Lucas-byte31/GREENHOUSE_V2/02_SW_SPEC/Photos/Menu5_KO_FAN.png

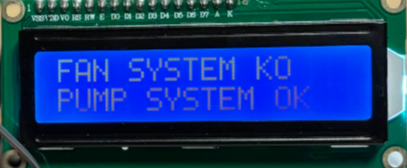
02_SW_SPEC/Photos/Menu5_KO_FAN.png
