Lucas-byte31/GREENHOUSE_V2/02_SW_SPEC/System_spec_v2.docx

# System Requirements SR – GREENHOUSE V2

Révision du document : v2 du 04/11/2026 – Migration STM32 (STM32CubeIDE) vers ESP32 (Arduino IDE) et introduction du temps réel (FreeRTOS).

Statuts : Inchangé = exigence V1 reconduite telle quelle ; Modifié v2 = exigence V1 précisée/quantifiée ; Nouveau v2 = exigence ajoutée ; Proposé v2 (à valider) = évolution de comportement soumise à validation ; Optionnel v2 = exigence souhaitable, non bloquante.

Méthodes de vérification : T = Test, M = Mesure, A = Analyse, I = Inspection (revue de code / de document).

## Template

SR-GH-0xx

Révision xx

Objet :

Rationale :

Vérification : T / M / A / I

Statut :

## Exigences fonctionnelles

SR-GH-001

Révision 01

Objet : Greenhouse doit pouvoir acquérir la température ambiante sur la plage 0 à 50 °C, avec une résolution affichée de 1 °C.

Rationale : Capteur TMP235 (10 mV/°C, 500 mV à 0 °C) : T = 100 × V − 50. Sur ESP32, la tension est lue en mV par analogReadMilliVolts() car l’ADC de l’ESP32 n’est pas linéaire (la conversion brute × 3,3 / 4095 de la V1 n’est plus valable).

Vérification : T – comparaison avec un thermomètre de référence (écart ≤ 2 °C).

Statut : Modifié v2

SR-GH-002

Révision 01

Objet : Greenhouse doit pouvoir acquérir l’humidité du sol sur la plage 0 à 100 %.

Rationale : Capteur capacitif Grove 101020614 : la tension de sortie diminue quand l’humidité augmente. H = (V_air − V) / (V_air − V_eau) × 100, saturée entre 0 et 100 %. Les points d’étalonnage V_air (air sec) et V_eau (immergé) sont à remesurer en mV sur la cible ESP32 (les valeurs V1 étaient en points ADC STM32).

Vérification : T – étalonnage air / eau puis contrôle à mi-plage.

Statut : Modifié v2

SR-GH-003

Révision 00

Objet : Greenhouse doit pouvoir être interactif vis-à-vis de l’opérateur.

Rationale : Pas besoin de reconfiguration (nouveau téléchargement), l’opérateur peut saisir les consignes et allumer/éteindre le ventilateur et/ou la pompe.

Vérification : T

Statut : Inchangé

SR-GH-004

Révision 00

Objet : Greenhouse doit pouvoir monitorer la température en fonction d’une consigne donnée.

Rationale : Consigne de température donnée par l’utilisateur.

Vérification : T

Statut : Inchangé

SR-GH-005

Révision 00

Objet : Greenhouse doit pouvoir monitorer l’humidité en fonction d’une consigne donnée.

Rationale : Consigne d’humidité donnée par l’utilisateur.

Vérification : T

Statut : Inchangé

SR-GH-006

Révision 01

Objet : Greenhouse doit réguler la température en Tout-Ou-Rien avec hystérésis : ventilateur ON si T ≥ Tcons, OFF si T < Tcons − 0,5 °C. Tcons est réglable de 0 à 51 °C par pas de 1 °C, valeur par défaut 25 °C.

Rationale : Formalisation de la loi implémentée en V1. L’hystérésis évite les commutations répétées du moteur autour du seuil.

Vérification : T – source de chaleur sur la sonde, observation des seuils ON/OFF.

Statut : Modifié v2

SR-GH-007

Révision 01

Objet : Greenhouse doit réguler l’humidité par commande PWM de la pompe selon r = H / Hcons : r ≤ 0,55 → 100 % ; 0,55 < r ≤ 1 → rampe linéaire de 100 % à 50 % ; r > 1 → pompe arrêtée. Hcons est réglable de 0 à 100 % par pas de 1 %, valeur par défaut 5 %.

Rationale : Formalisation de la loi implémentée en V1 (vitesse = −111,1 × r + 161,1). Le ralentissement à l’approche de la consigne limite le dépassement (overshoot). Valeur par défaut abaissée de 18 % (V1) à 5 % en V2 (décision du 04/11/2026), adaptée à l’étalonnage du capteur Grove (environ 10 % mesurés à l’air libre).

Vérification : T – mesure du rapport cyclique à l’oscilloscope pour 3 valeurs de r.

Statut : Modifié v2

SR-GH-008

Révision 00

Objet : Greenhouse doit pouvoir afficher les informations de températures et d’humidité sur une page d’un écran LCD.

Rationale : Menu 1 (cf. Design écran LCD).

Vérification : T

Statut : Inchangé

SR-GH-009

Révision 00

Objet : Greenhouse doit pouvoir afficher les consignes de température et d’humidité sur une page d’un écran LCD.

Rationale : Menus 2 et 3 (cf. Design écran LCD).

Vérification : T

Statut : Inchangé

SR-GH-010

Révision 00

Objet : Greenhouse doit pouvoir afficher l’état courant du ventilateur et de la pompe.

Rationale : Afficher ON ou OFF (Menu 4).

Vérification : T

Statut : Inchangé

SR-GH-011

Révision 01

Objet : Greenhouse doit détecter et afficher l’état du système : défaut ventilation si T > Tcons pendant plus de 15 s, ou si T > 80 °C ou T < −20 °C (sonde hors service) ; défaut pompe si H < Hcons pendant plus de 15 s, ou si H > 98 % (sonde hors service). Le défaut est signalé sur le Menu 1 (symbole ■) et détaillé sur le Menu 5.

Rationale : En V1 une sonde de température débranchée donnait −50 °C : elle était vue comme « température sous la consigne » et n’était pas détectée. Ajout du seuil bas −20 °C. La LED de signalisation de la V1 est supprimée en V2 (décision du 04/11/2026).

Vérification : T – débranchement de chaque sonde, consignes inatteignables (protocole V1 §8.3.5).

Statut : Modifié v2

SR-GH-012

Révision 00

Objet : Greenhouse doit proposer un mode manuel sur le Menu 4 : BP2 bascule le ventilateur ON/OFF, BP3 bascule la pompe à 100 % / 0 %. La régulation automatique est suspendue uniquement tant que le Menu 4 est affiché ; elle reprend à la sortie du menu.

Rationale : Comportement V1 formalisé (il n’était décrit que dans la notice, qui indiquait à tort 99 % pour la pompe).

Vérification : T – protocole V1 §8.3.4.

Statut : Nouveau v2

## Exigences de plateforme (migration ESP32)

SR-GH-013

Révision 00

Objet : Greenhouse doit fonctionner sur la carte Keyestudio ESP32 Plus (module ESP32-WROOM-32), développée sous Arduino IDE (core arduino-esp32). Le câblage de référence est le document « Schema de cablage.pptx » de GREENHOUSE V2.

Rationale : Changement de cible imposé par le module Systèmes Temps Réel. Le core arduino-esp32 repose sur ESP-IDF et embarque FreeRTOS : l’API FreeRTOS est utilisée directement (pas de surcouche Arduino pour le temps réel). Écart assumé vis-à-vis de la note de cadrage V1 (« sans abstraction type Arduino »), justifié dans le rapport.

Vérification : I

Statut : Nouveau v2

SR-GH-014

Révision 00

Objet : L’ESP32 est alimenté par USB ; la carte moteur MotoDriver2 est alimentée par une source 5 VDC dédiée, avec masse commune.

Rationale : Choix de câblage V2. Écart vis-à-vis de la source unique demandée en V1, à reporter dans la notice.

Vérification : I

Statut : Nouveau v2

SR-GH-015

Révision 00

Objet : L’écran LCD 2x16 doit être piloté via le bus I2C (module PCF8574) avec la librairie LCD_I2C (Blackhat).

Rationale : Remplace le driver parallèle 4 bits de la V1 (lcd.c). Libère des GPIO et réduit le câblage ; introduit une ressource partagée (bus I2C).

Vérification : T

Statut : Nouveau v2

SR-GH-016

Révision 00

Objet : La version migrée (avant temps réel) doit reproduire le comportement fonctionnel de la V1 : 5 menus, rôles des boutons, consignes par défaut (sauf Hcons, cf. SR-GH-007), plages de réglage, lois de régulation et diagnostic.

Rationale : Non-régression : la V1 sert de référence. Les évolutions de comportement sont tracées par les exigences au statut « Proposé v2 ».

Vérification : T – rejeu de la campagne de tests V1 (§8.3).

Statut : Nouveau v2

## Exigences temps réel

Les valeurs temporelles ci-dessous sont des objectifs de conception ; elles seront confirmées ou révisées après l’analyse WCET.

SR-GH-020

Révision 00

Objet : Le logiciel doit être structuré en tâches FreeRTOS à priorités fixes. Toutes les tâches applicatives sont épinglées sur un seul cœur (cœur 1, APP_CPU).

Rationale : Exigence du module. Le cœur 0 (PRO_CPU) reste dédié aux tâches système. L’apport théorique d’un fonctionnement bi-cœur est traité dans l’état de l’art et la conclusion du rapport.

Vérification : I

Statut : Nouveau v2

SR-GH-021

Révision 00

Objet : L’acquisition des capteurs doit être périodique, de période fixe Tacq = 100 ms, avec une gigue d’activation ≤ 1 ms.

Rationale : En V1 la boucle principale n’avait pas de période : la fréquence d’échantillonnage dépendait de la durée des affichages LCD, et le filtre à moyenne glissante sur 8 échantillons n’avait pas de constante de temps définie. Avec Tacq = 100 ms, la fenêtre du filtre vaut 0,8 s. Valeur révisable après l’analyse WCET.

Vérification : M – horodatage des activations (esp_timer) ou GPIO de trace à l’oscilloscope.

Statut : Nouveau v2

SR-GH-022

Révision 00

Objet : La commande des actionneurs doit être mise à jour au plus 500 ms après la mesure qui franchit un seuil de régulation.

Rationale : Contrainte de type temps réel ferme : un dépassement occasionnel est sans conséquence sur la serre (constantes de temps thermique et hydrique de l’ordre de la minute), mais il dégrade la régulation.

Vérification : M

Statut : Nouveau v2

SR-GH-023

Révision 00

Objet : Un appui sur un bouton doit être pris en compte (changement de page, modification de consigne ou bascule d’un actionneur) en moins de 100 ms ; l’écran correspondant doit être mis à jour en moins de 200 ms.

Rationale : Contrainte de type temps réel mou (confort opérateur ; 100 ms correspond au seuil de perception d’une réponse « instantanée »). En V1, les boutons + / − n’étaient traités que dans la fenêtre de rafraîchissement LCD de 500 ms.

Vérification : M – GPIO de trace entre l’interruption et la prise en compte.

Statut : Nouveau v2

SR-GH-024

Révision 00

Objet : Les mesures affichées doivent être rafraîchies au plus toutes les 500 ms ; l’écran n’est redessiné que si son contenu a changé.

Rationale : Reconduction du principe V1 (comparaison état courant / état précédent) qui évite le scintillement et limite l’occupation du bus I2C.

Vérification : T / M

Statut : Nouveau v2

SR-GH-025

Révision 00

Objet : Chaque bouton doit disposer de son propre anti-rebond. Une routine d’interruption ne fait que signaler l’événement à une tâche ; un appui n’est consommé que par le menu actif (aucun événement mémorisé ne doit agir plus tard sur un autre menu).

Rationale : En V1 l’anti-rebond de 200 ms était commun aux 3 boutons, et les appuis BP2/BP3 faits sur les menus 1 ou 5 restaient mémorisés puis modifiaient la consigne à l’arrivée sur le menu 2 ou 3.

Vérification : T – appuis BP2/BP3 sur les menus 1 et 5 puis passage aux menus 2/3 : consigne inchangée.

Statut : Nouveau v2

SR-GH-026

Révision 00

Objet : L’accès au LCD (bus I2C) et aux données partagées entre tâches (mesures, consignes, états des actionneurs, codes d’erreur) doit être protégé contre les accès concurrents : aucune tâche ne doit lire une donnée partiellement mise à jour.

Rationale : Introduit par le passage multitâche. Le choix du mécanisme (mutex, sémaphore, queue) est justifié dans le rapport.

Vérification : A / I

Statut : Nouveau v2

SR-GH-027

Révision 00

Objet : Aucune tâche ne doit effectuer d’attente active ; les attentes se font par vTaskDelay / vTaskDelayUntil ou par blocage sur un objet de synchronisation.

Rationale : En V1, lcd_wait_ms() était présentée comme non bloquante mais bouclait sur HAL_GetTick() : environ 4 ms de CPU par caractère envoyé au LCD.

Vérification : I

Statut : Nouveau v2

SR-GH-028

Révision 00

Objet : Le taux d’occupation CPU des tâches applicatives sur le cœur 1, U = Σ Ci / Ti, doit être ≤ 69 %.

Rationale : Borne de Liu & Layland (n → ∞ : ln 2 ≈ 69 %) : en deçà, l’ordonnançabilité Rate Monotonic est garantie quel que soit le nombre de tâches.

Vérification : A + M

Statut : Nouveau v2

SR-GH-029

Révision 00

Objet : Le WCET de chaque tâche doit être mesuré selon une méthode documentée (au moins 1000 activations, conditions pire cas provoquées), et son temps de réponse pire cas doit respecter son échéance avec une marge ≥ 20 %. L’instrumentation est activable par une directive de compilation et désactivée en fonctionnement normal.

Rationale : Approche WCET par mesure : elle donne le pire temps observé, que la marge vient couvrir (caches flash, interruptions, tâches système).

Vérification : M + A

Statut : Nouveau v2

SR-GH-030

Révision 00

Objet : Les tâches applicatives doivent être surveillées par le Task Watchdog Timer d’ESP-IDF : une tâche qui ne s’est pas signalée pendant 5 s provoque un redémarrage du système.

Rationale : Le « watchdog » de la V1 était un diagnostic fonctionnel (error_handler), pas un chien de garde : un blocage logiciel n’était pas détecté.

Vérification : T – blocage volontaire d’une tâche en mode test.

Statut : Nouveau v2

SR-GH-031

Révision 00

Objet : Sur défaut pompe, la pompe doit être arrêtée et maintenue arrêtée jusqu’à disparition du défaut. Sur défaut de sonde de température, le ventilateur doit être forcé ON.

Rationale : Évolution de comportement. Protection de la pompe contre la marche à sec (réservoir vide) et contre l’inondation si la sonde d’humidité est hors service. Le ventilateur ON est l’état sûr côté thermique.

Vérification : T

Statut : Nouveau v2

# Design Ecran LCD

Menu1 :

Temperature | x°C
Humidite | x%

Menu2 :

Temperature | x°C
Seuil | x°C

Menu3 :

Humidite | x%
Seuil | x%

Menu4 :

Pompe | ON/OFF
Ventilateur | ON/OFF

Menu5 :

LE SYSTEME

FONCTIONNE BIEN

Ou

FAN SYSTEM | OK/KO
PUMP SYSTEM | OK/KO

Machine à état : gestion de l’affichage

°C | +1
°C | -1

% | +1
% | -1

Pompe | ON/OFF
Ventilateur | ON/OFF

PB3∙PB2

PB2∙PB3

PB2∙PB3

PB2∙PB3

Menu 1

Menu 2

Menu 3

Menu 4

Menu 5

PB3∙PB2

PB3∙PB2

PB1

PB1

PB1

PB1

PB1
