Lucas-byte31/GREENHOUSE_V2/02_SW_SPEC/Schema de cablage.pptx

Écran LCD
I2C

GND – VCC – SIG2 -> Io19
SIG1 -> Io23

SCL SDA 5V GND

GND – VCC – SIG1 -> Io18

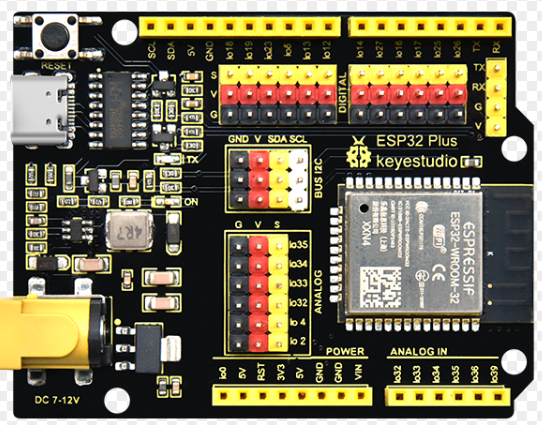
[picture p15: figure]

GND – VCC- OUT -> Io35

Capteur Température

Capteur Humidité

PB3

PB2

PB1

Alimentation 5VDC

Io16 to IN4
Io17 to IN3
Io25 to IN2
Io26 to IN1

De Io26

De Io25

IN1

IN2

Carte moteur

IN1

IN2

OUT3 OUT4

VCC GND

IN3

IN4

De Io17

De Io16

GND – VCC – SIG -> Io34

OUT2

OUT1

Pompe

Ventilateur

## Slide 2

Carte moteur SBC-MotorDriver2

FAN

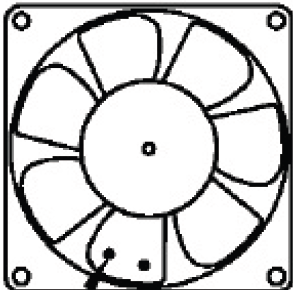
[picture p16: figure]

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
Io26

Io25

Io17

Io16

Alim +5.0V
