Lucas-byte31/GREENHOUSE_V2/02_SW_SPEC/Documents_V1/Rapport technique.pdf

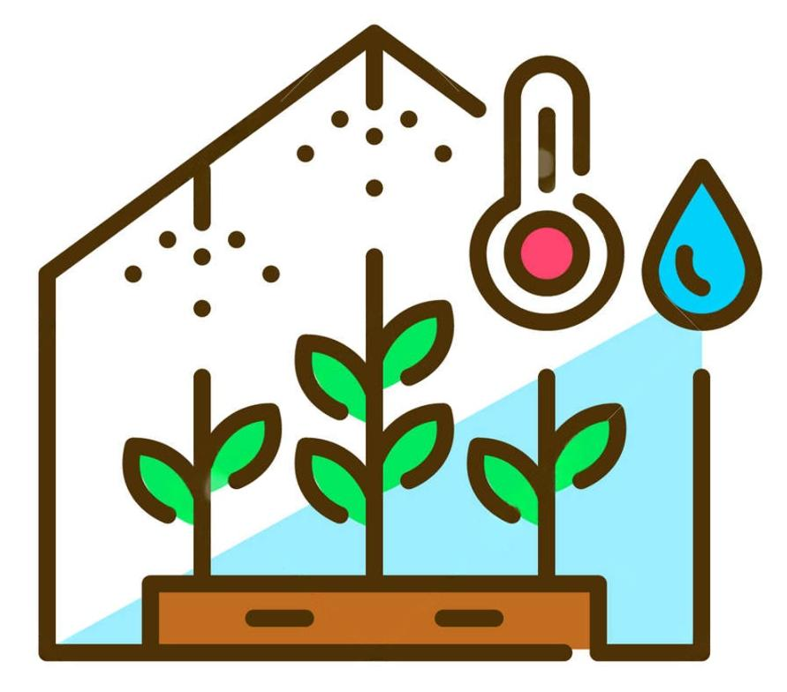
[picture p17: figure]

19 janvier 2026 | Page 1 sur 41

## Projet : Conception d’une Serre Intelligente

FISA S3E

Année : 2025–2026

Tuteur :

Mohamed AIT-BRAHIM

Groupe étudiants :

ALEMANY Paul

CHASTANET Bastien

JOUFFREAU Lucas

19 janvier 2026 | Page 2 sur 41

### Sommaire

19 janvier 2026 | Page 3 sur 41
8.2.2 Optimisation des ressources | 24
8.2.3 Logique de contrôle-commande | 24
8.2.4 Gestion des erreurs | 25
8.3. Tests et validation | 26
8.3.1 Validation de la chaîne d'acquisition (SR-GH-001, 002) | 26
8.3.2 Validation des boucles de régulation (SR-GH-004, 005, 006, 007) | 27
8.3.3 Validation de l'IHM et de l'interactivité (SR-GH-003, 008, 009) | 27
8.3.4 Validation de l'IHM et de l'interactivité (SR-GH-010) | 28
8.3.5 Test de sécurité et diagnostic (SR-GH-011) | 29
9. Gestion de projet / management | 31
9.1. Exigences demandées | 31
9.1. Organisation de l’équipe | 31
9.2. Répartition des tâches | 31
9.3. Difficultés rencontrées | 32
10. Analyse critique | 33
11. Bilan du projet | 34
12. Conclusion | 35
13. Glossaire | 36
Annexes | 37
Specification système | 37
Design écran LCD | 40
Notice d’utilisation | 41

### Table des figures

Figure 1 Synoptique général du système Greenhouse | 8
Figure 2 Architecture globale | 11
Figure 3 Câblage général | 12
Figure 4 câblage actionneurs | 13
Figure 5 câblage écran LCD | 13
Figure 6 Ventilation automatique | 14
Figure 7 Pompe automatique | 15
Figure 8 Gestion PWM de la Pompe | 16
Figure 9 Ventilation manuelle | 16
Figure 10 Pompe manuelle | 17
Figure 11 MAE gestion de l'affichage | 17
Figure 12 : Photo du prototype | 19
Figure 13 Control Flow | 21
Figure 13 : Répartition de taches, diagramme Gantt | 32

19 janvier 2026 | Page 4 sur 41

### 1. Résumé

Ce projet, réalisé dans le cadre du module Microcontrôleur, porte sur la conception et le développement d'un système embarqué de gestion pour une serre intelligente.

L'objectif principal est la régulation autonome de la température ambiante et de l'humidité du sol à l'aide d'un microcontrôleur type STM32.

Le système intègre une chaîne d'acquisition complète (capteurs analogiques température et humidité) et des algorithmes de contrôle-commande variés :
- Une régulation Tout-Ou-Rien avec hystérésis pour la ventilation,
- Un asservissement linéaire par modulation de largeur d'impulsion (PWM) pour l'irrigation,
- Une interface humain-machine (IHM) composée d'un écran LCD et de boutons-poussoirs permet un paramétrage dynamique des seuils et un mode de pilotage manuel,
- Une couche de diagnostic de sécurité (Error Handler) garantissant la fiabilité du prototype.

Les résultats valident un système autonome, robuste et conforme aux exigences du cahier des charges initial.

### 2. Documents référencés

### 2.1.Projet

Identifiant | Sujet | Référence
Note de cadrage | Note de cadrage serre intelligente | REF_001

### 2.2.Technique

Identifiant | Sujet | Référence
Datasheet SWI5-E | Datasheet alimentation CUI-INC | REF_002
Datasheet HD44780U | Datasheet écran LCD 2x16 HITACHI | REF_003
Datasheet stm32g031k8 | Datasheet microprocesseur stmmicroelectronics | REF_004
Datasheet MF50100V1 | Datasheet ventilateur sunon | REF_005
Datashet MotorDriver | Datasheet carte moteur Joy-IT | REF_006
Datasheet nucleo32-g031k8 | Datasheet microcontrôleur nucleo32-g031k8 | REF_007
Datasheet TMP235 | Datasheet sonde de température texas instrument | REF_008
Datasheet 101020614 | Datasheet sonde d’humidité Seed-Studio | REF_009

19 janvier 2026 | Page 5 sur 41

### 3. Introduction

L'agriculture moderne fait face à des défis sans précédent :
- optimisation des ressources hydriques,
- maîtrise de la consommation énergétique,
- adaptation aux aléas climatiques.

Dans ce contexte, les serres intelligentes s'imposent comme une solution technologique clé pour garantir un environnement de culture optimal tout en minimisant l'intervention humaine.

Le projet présenté dans ce rapport s'inscrit dans le cadre du module "Microcontrôleur". L'objectif était de concevoir, en une durée limitée de 38 heures, un démonstrateur fonctionnel de serre automatisée capable de réguler de manière autonome la température et l'humidité du sol.

Ce travail a nécessité une approche pluridisciplinaire mêlant :
- Électronique (chaîne d'acquisition et pilotage d'actionneurs),
- Automatique (asservissement PWM et régulation à hystérésis),
- Informatique embarquée (développement en langage C sur architecture ARM Cortex).

Ce rapport détaille les étapes de cette réalisation, depuis l'analyse des besoins jusqu'à la validation expérimentale du prototype, en mettant en avant les choix techniques qui ont permis d'aboutir à un système fiable et ergonomique.

19 janvier 2026 | Page 6 sur 41

### 4. État de l’art

Les serres automatisées représentent aujourd’hui une réponse technologique aux enjeux de l’agriculture moderne dite 4.0 et de l’autoproduction alimentaire.

Elles permettent de surveiller et de contrôler des paramètres essentiels tels que l’humidité du sol, la température ou la luminosité, en s’appuyant sur des systèmes embarqués compacts et économes en énergie.

Plusieurs travaux de recherche mettent en évidence l’intérêt de ces dispositifs.

En 2021, Vinoth Kumar P., K.C. Ramya, Abishek J.S., Arundhathy T.S., Bhavvya B. et Gayathri V. ont présenté lors de l’International Conference on Signal Processing and Communication (ICSPC) un projet intitulé « Smart Garden Monitoring and Control System with Sensor Technology » (1). Leur prototype démontre la faisabilité d’un suivi automatisé de l’humidité du sol et de la température, associé à un contrôle automatique de l’irrigation.

Solutions technologiques actuelles :

Le marché et la communauté open-source s'articulent principalement autour de trois piliers :
- Microcontrôleurs : Arduino (accessibilité), ESP32 (connectivité Wi-Fi) et STM32 (performance industrielle et basse consommation),
- Capteurs : Sondes capacitives (DHT22) pour l'humidité (plus durables que les versions résistives) et capteurs analogiques de précision pour la température,
- Actionneurs : Pompes submersibles et ventilateurs à flux axial.

Limites identifiées et positionnement du projet :

Bien que ces solutions soient performantes, elles présentent des lacunes auxquelles ce projet tente de répondre.

Dépendance aux bibliothèques haut niveau :
- De nombreux projets utilisent des couches logicielles opaques (type Arduino),
- Dans notre projet, l'utilisation du C bas niveau et des drivers HAL sur STM32 garantit une maîtrise totale du cycle d'instruction et de la consommation mémoire.

Stabilité des mesures :
- Les systèmes basiques sont sensibles au bruit électronique,
- L'implémentation d'un filtre numérique à moyenne glissante dans notre solution permet de s'affranchir de cette limite.

Absence de diagnostic :

- La plupart des prototypes ne gèrent pas la défaillance d'un composant,
- Notre intégration d'un module de gestion d'erreurs (Error Handler) apporte une dimension de sécurité industrielle souvent absente des projets pédagogiques.
(1) Vinoth Kumar P., K.C. Ramya, Abishek J.S., Arundhathy T.S., Bhavvya B., Gayathri V., Smart Garden Monitoring and Control System with Sensor Technology, ICSPC, Coimbatore, 2021.

19 janvier 2026 | Page 7 sur 41

### 5. Présentation du projet

Le projet de conception d’une serre intelligente s’inscrit dans le cadre du module Microcontrôleur de quatrième année du cycle ingénieur.

L’objectif pédagogique est de nous permettre de mettre en pratique les compétences acquises en programmation bas niveau et en conception de systèmes embarqués.

Sur le plan technique, il vise à démontrer la capacité d’un microcontrôleur à collecter des données environnementales, à prendre des décisions en fonction de seuils configurés et à piloter automatiquement des actionneurs afin de maintenir des conditions optimales pour la culture dans une serre.

Le cahier des charges fixe plusieurs exigences précises :

- Le système doit être capable de mesurer l’humidité du sol et la température ambiante grâce à des capteurs adaptés.
- Il doit également piloter une pompe pour l’irrigation et un ventilateur pour la régulation thermique.
- Une interface locale composée d’un écran et de boutons poussoirs doit permettre à l’utilisateur de consulter les données et d’interagir directement avec le système.
- L’automatisation repose sur la comparaison des valeurs mesurées avec des seuils configurables, ce qui permet au microcontrôleur de déclencher les actions nécessaires sans intervention humaine.

Le projet doit respecter plusieurs contraintes technologiques :

- Le système doit fonctionner sur un microcontrôleur de type STM32 ou ESP32, sans recours à une couche d’abstraction comme Arduino.
- Les communications entre les différents composants doivent se limiter à des interfaces simples telles que GPIO, ADC/DAC ou UART.
- L’ensemble doit être alimenté par une source unique en 5 ou 12 volts et conçu de manière propre et fiable pour assurer la robustesse et la réplicabilité du prototype.

L'absence de framework type Arduino nous a imposé une gestion directe des registres via la bibliothèque HAL (Hardware Abstraction Layer), garantissant ainsi une empreinte mémoire optimisée et une meilleure compréhension de la gestion des interruptions et des timers du microcontrôleur.

En résumé, ce projet combine des objectifs pédagogiques et techniques clairs, un cahier des charges précis et des contraintes réalistes, afin de permettre aux étudiants de concevoir une serre intelligente fonctionnelle et représentative des enjeux actuels de l’automatisation agricole.

Le livrable final comprend ce rapport ainsi que le code du projet et une présentation du fonctionnement du projet.

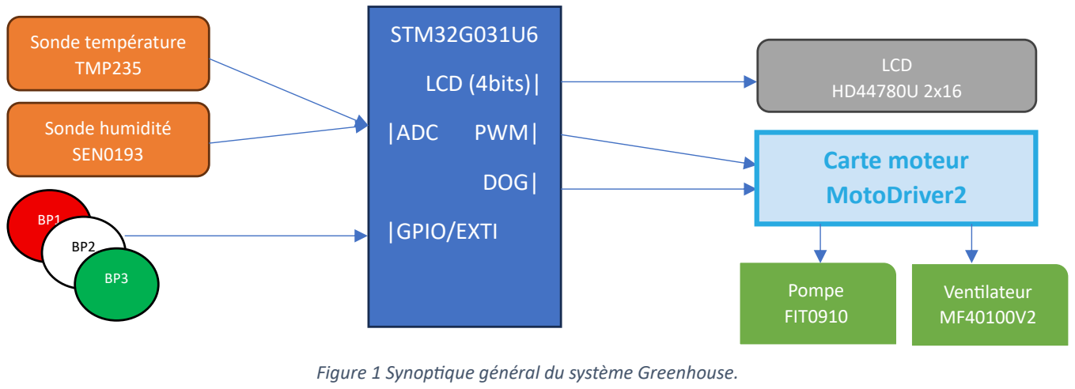
[picture p18: figure]
Sonde température TMP235; Sonde humidité SEN0193; STM32G031U6; LCD (4bits)|; |ADC; PWM|; DOG|; |GPIO/EXTI; LCD HD44780U 2x16; Carte moteur MotoDriver2; Pompe FIT0910; Ventilateur MF40100V2

19 janvier 2026 | Page 8 sur 41

### 5.1.Synthèse des fonctions de service

Afin de répondre au cahier des charges, le système a été décomposé en quatre fonctions principales :

Fonction | Description technique | Composant associé
Acquérir | Mesure des grandeurs physiques analogiques | Sonde température : TMP235 Sonde humidité : SEN0193
Traiter | Analyse des données et calcul des lois de commande | Microcontrôleur : stm32g031k8
Communiquer | Interface utilisateur et réglage des seuils | Ecran LCD : HD44780U 2x16 Boutons-poussoirs
Agir | Régulation physique de l’environnement | Pompe (PWM) : FIT0910 Ventilateur : MF40100V2 Via carte moteur : MotoDriver2

### 5.2.Synoptique du système

Le synoptique suivant illustre l'architecture modulaire du prototype.

Le STM32G031U6 centralise les données analogiques via son ADC et gère les interactions utilisateurs par des interruptions externes (EXTI).

Le pilotage des actionneurs est différencié : un signal PWM assure une irrigation progressive, tandis que le ventilateur est commandé en Tout-Ou-Rien via le driver de puissance.

Figure 1 Synoptique général du système Greenhouse.

19 janvier 2026 | Page 9 sur 41

### 6. Analyse des choix techniques

### 6.1.Analyse économique et choix des composants

Le choix du microcontrôleur s’est porté sur un STM32. Ce composant est largement disponible sur le marché, avec des cartes de développement comme les Nucleo ou les BluePill proposées à des prix accessibles, généralement compris entre 10 et 25 euros.

Pour la mesure de l’humidité du sol, un capteur capacitif de type SEN0193 a été retenu.
Ce capteur est fiable et résistant à la corrosion, contrairement aux capteurs résistifs plus fragiles. Son prix se situe autour de 5 à 10 euros, ce qui en fait une solution économique et durable.

La température est mesurée à l’aide d’un capteur TMP235, très répandu dans les projets embarqués. Ce capteur combine précision et simplicité d’intégration, pour un coût moyen de 5 euros.

L’affichage des données locales est assuré par un écran LCD 2x16. Ce type d’écran est largement utilisé dans les projets étudiants en raison de sa simplicité d’utilisation et de son faible coût, généralement inférieur à 10 euros. Il permet de répondre à l’exigence d’une interface locale tout en restant dans une enveloppe budgétaire limitée.

Pour le pilotage des actionneurs, une pompe à eau et un ventilateur ont été choisis. La pompe, de type FIT0910, est disponible pour un prix compris entre 10 et 15 euros, tandis que le ventilateur MF40100V2 se situe autour de 5 à 10 euros.

La carte MotoDriver2, indispensable pour alimenter et protéger ces actionneurs, est proposée à un prix moyen de 10 à 15 euros.

L’interface utilisateur est complétée par des boutons poussoirs, dont le coût est négligeable (moins d’un euro par unité). L’ensemble du système est alimenté par une source unique en 5 ou 12 volts, via un bloc secteur ou une batterie externe, dont le prix varie entre 10 et 20 euros selon la solution retenue.

### 6.2.Justification des choix technologiques

### 7.2.1 Capteurs et traitement du signal

Le choix des composants ne s'est pas limité au coût, mais à la pertinence de leur interface électronique :

- Humidité (SEN0193) : Le choix d'un capteur capacitif est stratégique. Contrairement aux modèles résistifs, il n'y a aucune électrolyse entre les électrodes, ce qui évite la dégradation des mesures dans le temps.
- Aspect technique : La sortie est analogique, traitée par l'ADC du STM32 sur 12 bits. Un filtre à moyenne glissante a été implémenté en C pour stabiliser la mesure contre le bruit de commutation de l'alimentation.
- Température (TMP235) : L'utilisation d'une sonde analogique linéaire (10mV/°C) permet une lecture directe et rapide sans protocole complexe, facilitant l'implémentation de la loi de commande.

19 janvier 2026 | Page 10 sur 41

### 7.2.2 Pilotage des actionneurs

Le pilotage des moteurs nécessite une distinction entre puissance et commande :

Interface de puissance : Le driver MotoDriver2 (Pont en H).

Il permet d'isoler le circuit logique (3.3V) de la puissance (5V/12V) et de protéger le STM32 contre les retours de courants inductifs des moteurs.

Modulation de Largeur d'Impulsion (PWM) : Pour la pompe, nous avons choisi un pilotage par PWM. Cela permet de varier le débit d'eau de manière fluide, évitant ainsi les chocs hydrauliques et permettant un arrosage plus précis par rapport à un simple ON/OFF.

Régulation par Hystérésis : Pour le ventilateur, une logique à hystérésis a été retenue afin d'éviter les commutations trop fréquentes autour du seuil de température, prolongeant ainsi la durée de vie du matériel.

### 7.2.3 Architecture logicielle

L'architecture a été pensée pour être modulaire et évolutive.

Séparation des couches : Le code est divisé en modules indépendants (Hardware Abstraction vs Logic Application).

Optimisation mémoire : Nous avons développé nos propres fonctions d'affichage pour éviter l'utilisation de bibliothèques standards trop gourmandes en ressources, maximisant ainsi l'autonomie et la rapidité du système.

### 7.2.4 Contraintes et sécurité

La fiabilité est assurée par le module Error Handler.

Ce "Watchdog" logiciel surveille la cohérence des mesures (ex: une température qui ne baisse pas malgré le ventilateur actif).

En cas de défaut, le système bascule en mode sécurité avec une alerte visuelle LED et affichage LCD.

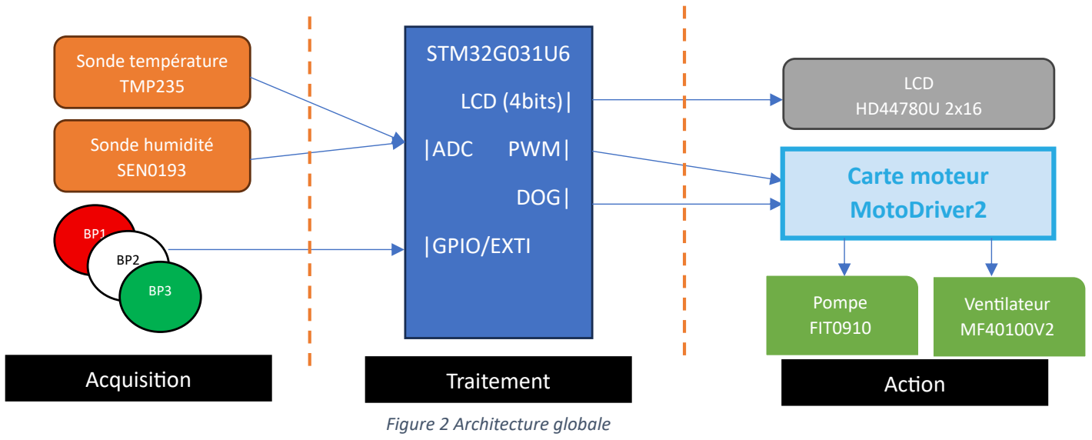
[picture p19: figure]
Sonde température TMP235; Sonde humidité SEN0193; STM32G031U6; LCD (4bits)|; |ADC; PWM|; DOG|; |GPIO/EXTI; LCD HD44780U 2x16; Carte moteur MotoDriver2; Pompe FIT0910; Ventilateur MF40100V2; Acquisition; Traitement; Action; Figure 2 Architecture globale

19 janvier 2026 | Page 11 sur 41

### 7. Conception et modélisation du système

### 7.1.Architecture globale

Le système est divisé en trois couches telles que décrites dans le synoptique suivant.

### 7.2.Spécifications du système (Exigences)

Le système est intégralement décrit dans le §Annexes - Specification système.

Spécification synthétique :
Exigence | Objet | Rationale
SR-GH-001/002 | Acquisition | Mesure de la Température (°C) et de l'Humidité (%) via ADC.
SR-GH-004/005 | Monitoring | Comparaison des mesures par rapport aux consignes utilisateur.
SR-GH-008/011 | IHM | Affichage multi-pages (Menu 1 à 5) et indicateurs d'état (OK/Défaut).
SR-GH-003 | Interactivité | Modification des seuils en temps réel sans reprogrammation.

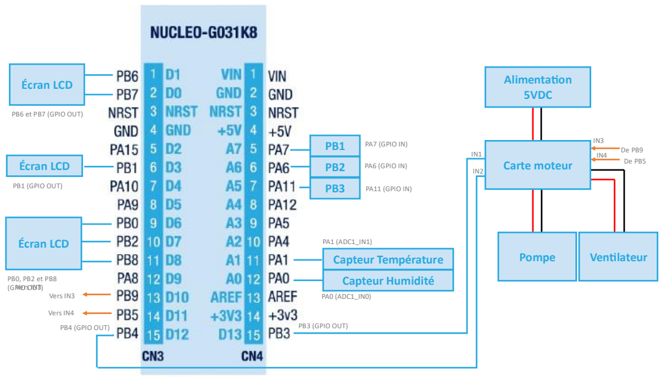
[picture p20: figure]
Capteur Température; Capteur Humidité; Écran CD; PA0 (ADC1_IN0); PA1 (ADC1_IN1); PA7 (GPIO IN); PA6 (GPIO IN); PA11 (GPIO IN); PB6 et PB7 (GPIO OUT); PB3 (GPIO OUT); Pompe; Ventilateur; Carte moteur; PB4 (GPIO OUT); Alimentation 5VDC; PB1 (GPIO OUT); PB0, PB2 et PB8 (GPIO OUT Vers IN3); Vers IN3; Vers IN4

19 janvier 2026 | Page 12 sur 41

### 7.3.Schémas de câblage et interface matérielle

### 7.3.1 Câblage général

Le STM32 est le cœur de calcul, les échanges avec le monde extérieur sont réalisés de la sorte :
- Entrées Analogiques : Température sur PA0 (ADC1_IN0) et Humidité sur PA1 (ADC1_IN1).
- Interface Utilisateur : 3 boutons-poussoirs sur PA7, PA6 et PA11.
- L'écran LCD est piloté sur un bus de données 4 bits (PB0, PB1, PB2, PB8) avec signaux de contrôle sur PB6 (RS) et PB7 (EN).
- Puissance :
- Utilisation du timer TIM16_CH1 sur PB4 pour générer le signal PWM de la pompe.
- Le ventilateur est piloté en GPIO standard sur PB3. Le tout transite par la carte de puissance SBC-MotorDriver2.

Figure 3 Câblage général

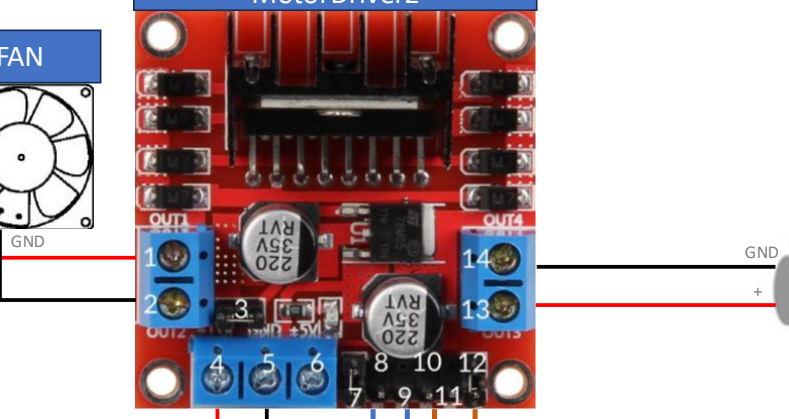
[picture p21: figure]
GND
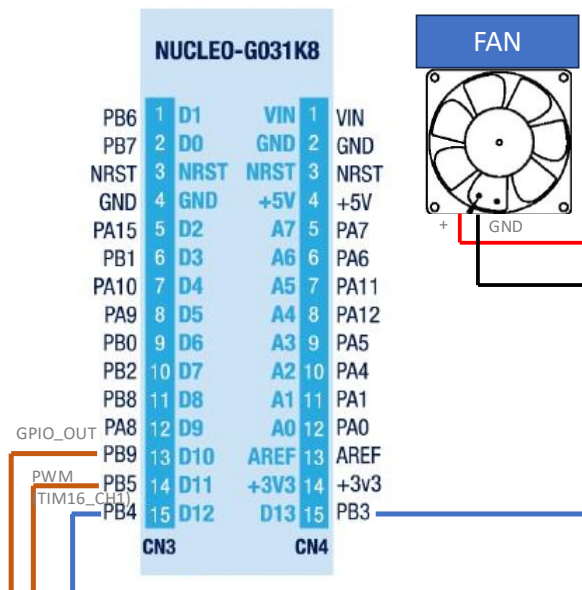
[picture p22: figure]
FAN; PWM (TIM16_CH1); GPIO_OUT
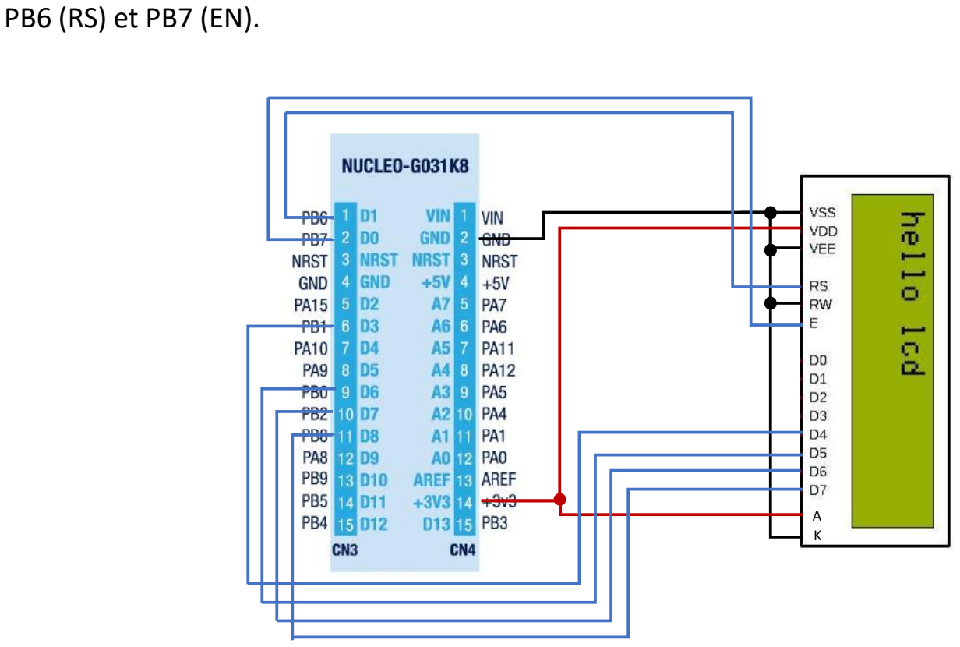
[picture p23: figure]

19 janvier 2026 | Page 13 sur 41

### 7.3.2 Câblage actionneurs

La carte moteur SVC-MotorDriver2 permet de séparer la partie puissance des actionneurs (5-12VDC) de la partie information (3.3VDC).

Figure 4 câblage actionneurs

### 7.3.3 Câblage écran LCD

L'écran LCD est piloté sur un bus de données 4 bits (PB0, PB1, PB2, PB8) avec signaux de contrôle sur

Figure 5 câblage écran LCD

Carte moteur SBC-MotorDriver2

Alim 5-12V

GND | IN1 | IN2
IN3 | IN4

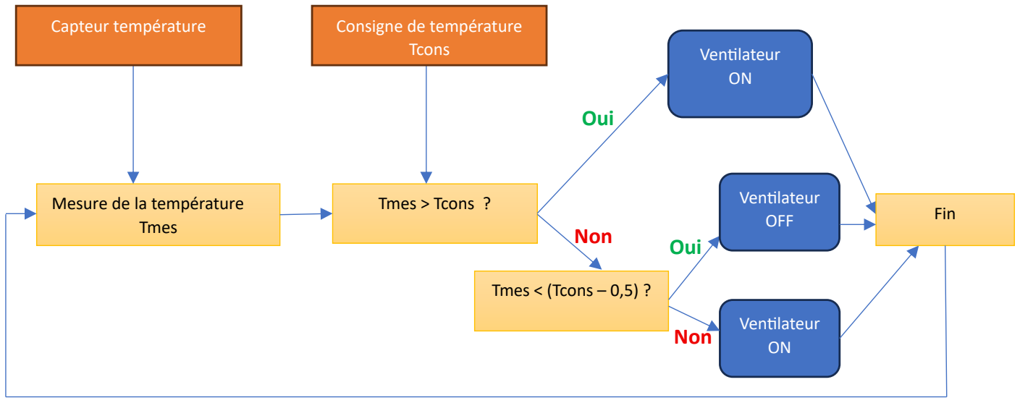
[picture p24: figure]
Mesure de la température Tmes; Capteur température; Tmes > Tcons ?; Ventilateur ON; Consigne de température Tcons; Fin; Oui; Non; Tmes < (Tcons – 0,5) ?; Ventilateur OFF

19 janvier 2026 | Page 14 sur 41

### 7.4.Modélisation logicielle

Le système a été pensé pour pouvoir fonctionner en deux modes distincts, Automatique et Manuel.

En automatique, c’est le système asservi qui régule la température et l’humidité en fonction de consignes.

En Manuel, c’est l’utilisateur qui active ou éteint les actionneurs.

### 7.4.1 Mode automatique

En mode automatique, les systèmes de gestion de température et d’humidité sont gérés en fonction de consignes utilisateur.

Régulation de la température (hystérésis) :

Suivant la consigne Tcons, si la température mesurée Tmes est au-dessus de Tcons alors le ventilateur se met en fonctionnement.

Le ventilateur fonctionne en « Marche/Arrêt » il est soit allumé soit éteint.

Pour éviter des ON/OFF intempestifs quand Tmes est très proche de Tcons, le point d’arrêt du ventilateur se fait légèrement sous la consigne à Tcons-0.5°C.

Figure 6 Ventilation automatique

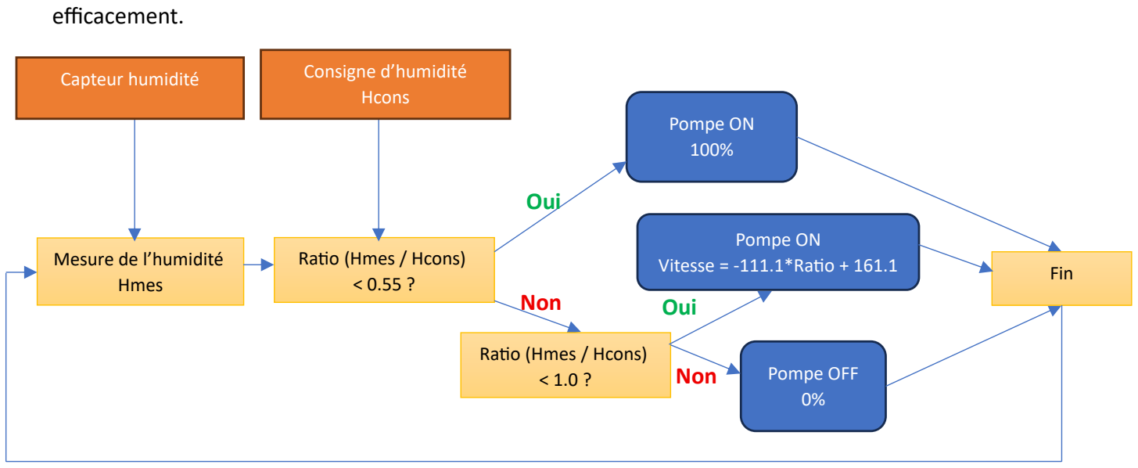
[picture p25: figure]
efficacement.; Mesure de l’humidité Hmes; Capteur humidité; Ratio (Hmes / Hcons) < 0.55 ?; Pompe ON 100%; Pompe OFF 0%; Consigne d’humidité Hcons; Fin; Oui; Non; Ratio (Hmes / Hcons); Pompe ON Vitesse = -111.1*Ratio 161.1

19 janvier 2026 | Page 15 sur 41

Gestion de l’humidité (Rampe PWM):

En mode automatique, le système utilise une régulation par Modulation de Largeur d'Impulsion (PWM). Contrairement au ventilateur, la pompe varie sa vitesse.

Plus l'écart entre l'humidité réelle et la consigne est grand, plus le signal PWM est élevé pour arroser

Figure 7 Pompe automatique

La vitesse de la pompe est calculée dynamiquement selon l'écart entre l'humidité mesurée et le seuil de consigne.

Zone de puissance maximale (100%) : Si l'humidité descend en dessous de 55% de la consigne, la pompe tourne à plein régime pour réagir vite.

Zone de régulation linéaire : Entre 55% et 100% de la consigne, la vitesse diminue linéairement suivant l'équation y = -111,1x 161,1.

Zone d'approche douce (Entre 55% et 50% de la consigne) : Juste avant d'atteindre la consigne, la pompe maintient un débit réduit de 50% pour éviter de détremper le sol par inertie.

Cette rampe permet de réduire l'usure mécanique de la pompe en évitant les arrêts/redémarrages brutaux.

Elle permet également d'éviter l'overshoot (dépasser la consigne d'humidité) grâce au ralentissement

à l'approche du seuil.

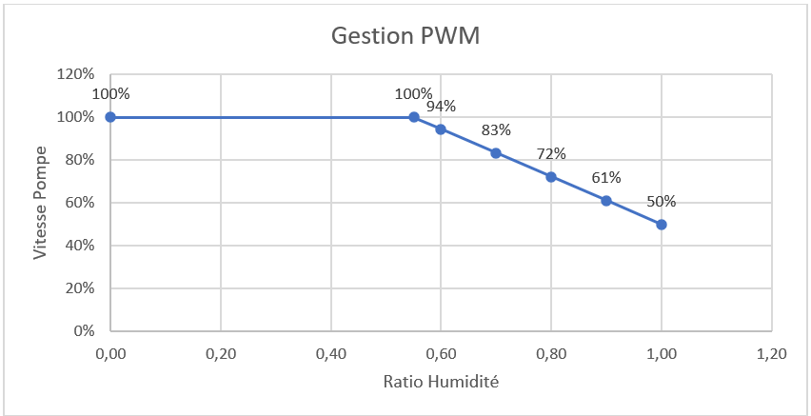
[picture p26: figure]
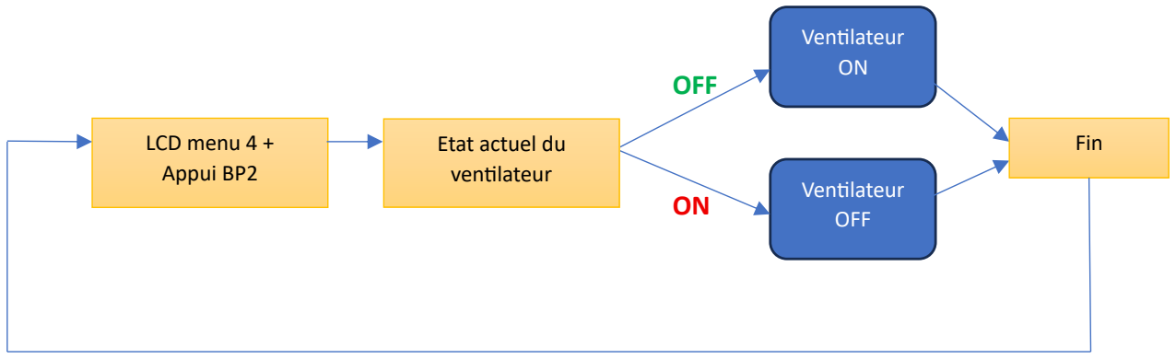
[picture p27: figure]
LCD menu 4 Appui BP2; Ventilateur ON; Ventilateur OFF; Fin; OFF; Etat actuel du ventilateur

19 janvier 2026 | Page 16 sur 41

La courbe ci-dessous modélise la vitesse de la pompe (en %) en fonction du rapport Hmes/Hcons.

Figure 8 Gestion PWM de la Pompe

### 7.4.2 Mode manuel

En mode manuel, les systèmes de gestion de température et d’humidité sont activés par l’opérateur. Les sécurités automatiques d’arrêt de la ventilation et/ou de la pompe sont désactivées. L'utilisateur est responsable du refroidissement et de l’humidification.

Gestion de la température :

Le ventilateur fonctionne en « Marche/Arrêt » il est soit allumé soit éteint.

Figure 9 Ventilation manuelle

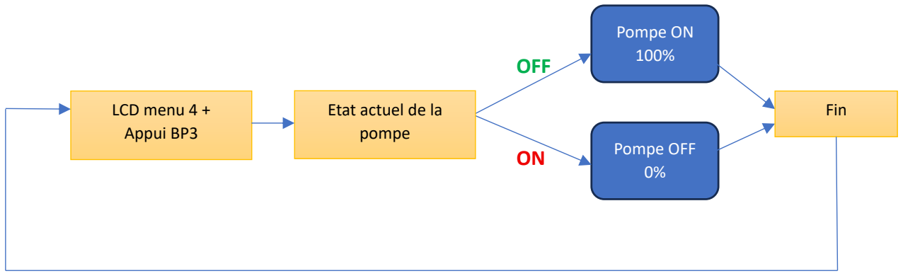
[picture p28: figure]
LCD menu 4 Appui BP3; Pompe ON 100%; Pompe OFF 0%; Fin; OFF; Etat actuel de la pompe
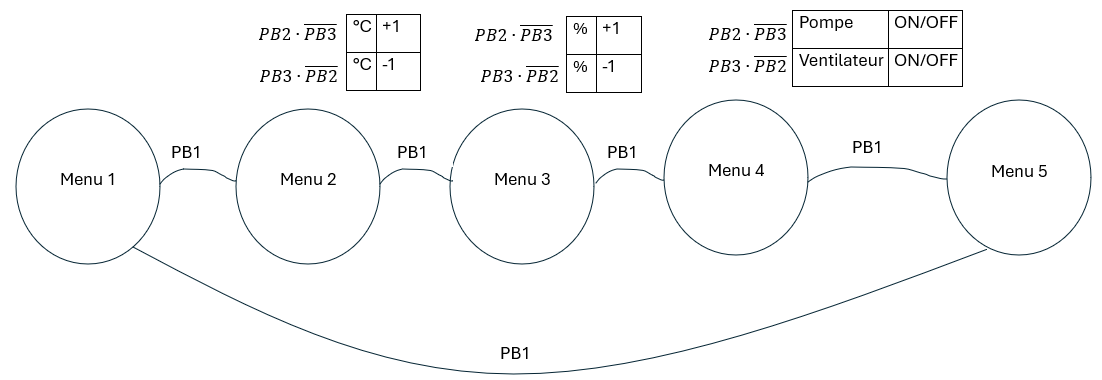
[picture p29: figure]

19 janvier 2026 | Page 17 sur 41

Gestion de l’humidité :

L’activation manuelle de la pompe se fait à vitesse fixe (100%).

Figure 10 Pompe manuelle

### 7.5.Description détaillée du fonctionnement

Le fonctionnement du système Greenhouse repose sur une architecture à division temporelle. Le microcontrôleur scrute les capteurs, met à jour les lois de régulation, puis rafraîchit l'interface utilisateur. Le comportement du système peut être décrit comme ceci:

A. La machine d'états de l'IHM (Gestion des Menus)

Figure 11 MAE gestion de l'affichage

Pour répondre à l'exigence d'interactivité (SR-GH-003), l'interface LCD est organisée en 5 pages contextuelles, sélectionnables via les boutons-poussoirs. Cette structure permet une navigation intuitive malgré la taille restreinte de l'écran (2x16) :

- Menu 1 (Monitoring) : Affichage dynamique des mesures brutes traitées (T° en °C et H en %).
- Menus 2 & 3 (Configuration) : Permettent à l'opérateur de modifier les seuils critiques.

L'appui sur les boutons "Plus" ou "Moins" incrémente les variables de consigne stockées en mémoire.

19 janvier 2026 | Page 18 sur 41
- Menu 4 (Pilotage Manuel) : Mode de forçage permettant de tester les actionneurs indépendamment des capteurs (utile pour la maintenance).
- Menu 5 (Diagnostic) : Affiche l'état du système.

Le design des différents menu est donné en §Annexes - Design écran LCD.

B. Algorithmes de Régulation Automatisée
La régulation s'active dès que le système est en mode automatique. Deux logiques distinctes sont appliquées :

1- Régulation Thermique (Ventilation) : Basée sur une logique de type "Tout-Ou-Rien" avec hystérésis. Le ventilateur s'active si la température dépasse le seuil défini (ex: 25°C) et ne se coupe que lorsqu'elle repasse sous une limite de sécurité (ex: 25°C – 0.5°C). Cette marge évite les micro-déclenchements nuisibles au moteur.

2- Régulation Hydrique (Irrigation) : Utilise une commande proportionnelle via le signal PWM (TIM16_CH1). Si l'humidité descend sous le seuil (SR-GH-007), la pompe s'active. La vitesse de pompage est ajustée dynamiquement pour garantir un apport d'eau progressif.

C. Surveillance et Sécurité (Error Handler)
Conformément à l'exigence SR-GH-011, une couche de surveillance logicielle tourne en arrière-plan. Elle compare l'état des actionneurs avec l'évolution des mesures :
- Si la pompe est active mais que l'humidité ne remonte pas après 15 secondes, le système lève une erreur "Défaut Pompe" (interprété comme un réservoir vide).
- Si une erreur est détectée, la LED de statut passe en mode clignotement rapide et le message correspondant est envoyé sur le Menu 5 du LCD.

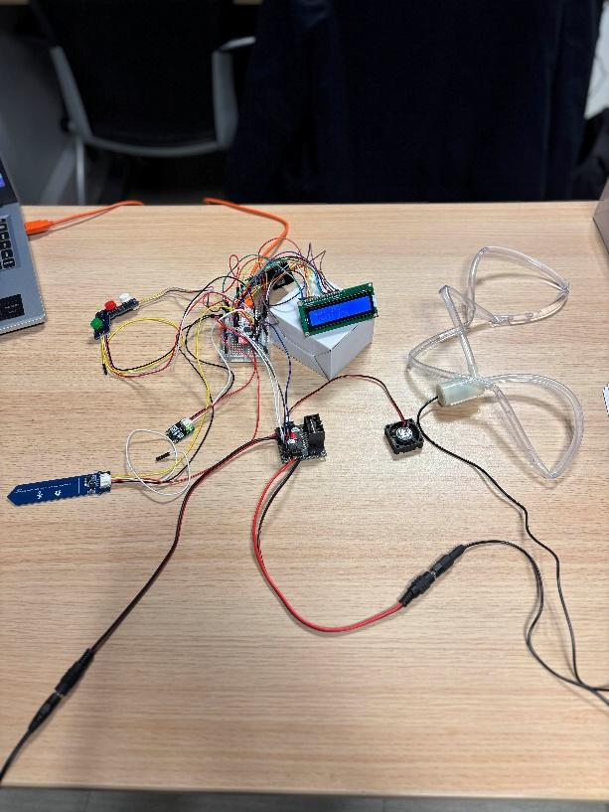
[picture p30: figure]

19 janvier 2026 | Page 19 sur 41

### 8. Réalisation et implémentation

### 8.1.Montage matériel

Le prototype du système est composé d’un écran LCD et de trois boutons poussoir servant d’interface utilisateur.

Il possède aussi un capteur d’humidité ainsi qu’un capteur de température servant à faire les mesures permettant de contrôler la pompe et le ventilateur qui sont contrôlés par un driver moteur piloté lui-même par un STM32G031U6.

Le montage suivant a été présenté en soutenance.

La partie commande (PB) a été ségréguée de la partie mesure (capteurs).

De même, la partie Affichage (écran LCD) est ségréguée de la partie actionneurs (pompe et ventilateur).

Figure 12 : Photo du prototype

19 janvier 2026 | Page 20 sur 41

### 8.2.Implémentation logicielle

Le développement logiciel a été réalisé en langage C sous l'environnement STM32CubeIDE.

Le code est disponible dans un repo GITHUB dans sa branche « main ».

Pour le télécharger :

1- Demander l’accès au projet au détenteur du projet (Lucas Jouffreau) 2- Sur une machine où GIT est installé, rentrer les commandes suivantes
a. git clone https://github.com/Lucas-byte31/Greenhouse.git
b. cd Greenhouse // aller sur le dossier cloné
c. git checkout main // s’assurer que vous êtes bien sur la branche main

L'architecture a été pensée pour être modulaire, séparant la gestion des périphériques (Drivers) de la logique de contrôle (Application).

Le flux de contrôle du système est centralisé dans le fichier main.c.

Afin de garantir une réactivité optimale, nous avons évité les fonctions bloquantes.

Le programme suit un cycle déterministe : il sollicite le module capteurs.c pour obtenir des données stables, exécute les algorithmes de régulation, puis délègue la gestion de l'affichage au lcd_page_manager.c.

Cette séparation stricte des responsabilités permet, par exemple, de modifier la logique de l'écran sans impacter la précision de la régulation thermique.

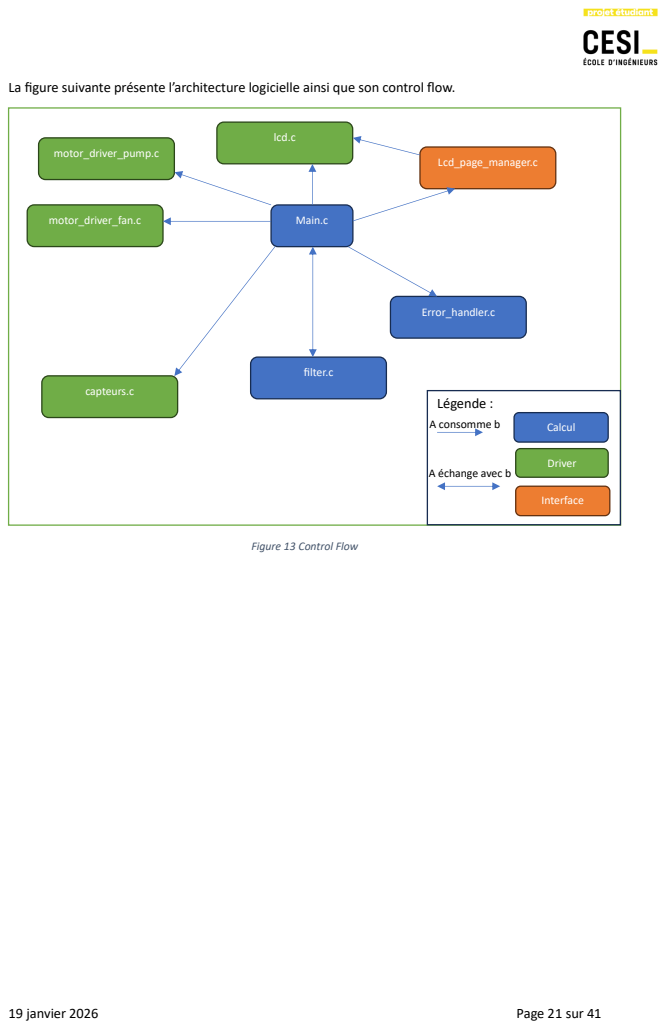
[picture p31: page 21]
19 janvier 2026; Page 21 sur 41; Main.c; motor_driver_pump.c; motor_driver_fan.c; lcd.c; capteurs.c; Lcd_page_manager.c; Error_handler.c; filter.c; Driver; Calcul; Interface; Légende :; A consomme b; A échange avec b

La figure suivante présente l’architecture logicielle ainsi que son control flow.

Figure 13 Control Flow

19 janvier 2026 | Page 22 sur 41

### 8.2.1 Structure du projet

Afin de faciliter le travail collaboratif et la maintenance, le code a été découpé en plusieurs modules :

- Couche d'Abstraction Matérielle (HAL) : Utilisation des bibliothèques de STMicroelectronics pour configurer les registres des périphériques (ADC, PWM, GPIO).
- Drivers (lcd.c/h, capteurs.c/h, motor_driver_fan.c/h, motor_driver_pump.c/h). Ces fichiers contiennent les fonctions de bas niveau. Par exemple, le driver LCD gère le protocole de communication 4 bits et l'initialisation du contrôleur HD44780, masquant la complexité pour le programmeur principal.
- Gestionnaire d'Interface (lcd_page_manager.c/h) : Ce module gère la machine d'états de l'afficheur (les 5 menus spécifiés) et le rafraîchissement sélectif de l'écran pour éviter les scintillements.

Le détail de chaque fonction implémentée dans chaque unité logicielle est donné ci-dessous.

8.2.1.1 main.c
Gère la boucle principale.

Main -
- Initialisation
- Lecture capteurs
- Prise de décision
- Affichage
- Monitoring
HA _GPIO_EXTI_Rising_Callback - Fourni la fonction d’interruption des boutons-poussoirs. ReadADC_Channel - Fourni la fonction de lecture ADC.
ED_ INK - Fourni la fonction de clignotement d’un LED.

8.2.1.2 motor_driver_pump.c
Fourni les services pour activer/désactiver et retourner l’état de la pompe.

Pump_Init - initialisation de la pompe

Pump_SetSpeed - Définit la vitesse de la pompe en %

Pump_Stop - Arrêt de la pompe

Pump_IsOn - Retourne l’état de la pompe (actif/éteint)

19 janvier 2026 | Page 23 sur 41

8.2.1.3 motor_driver_fan.c
Fourni les services pour activer/désactiver et retourner l’état du ventilateur.

Motor_On - Activation du ventilateur

Motor_Off - Arrêt du ventilateur

Motor_IsOn - Retourne l’état du ventilateur

8.2.1.4 capteurs.c
Assure la conversion Analogique/ numérique pour les données mesurées.

CAPTEURS_ComputeTemperature - Convertit la valeur brute de l'ADC en température Celsius

CAPTEURS_ComputeHumidity - Convertit la valeur brute de l'ADC en pourcentage d'humidité

8.2.1.5 filter.c
Fourni le service de filtre numérique à moyenne glissante pour supprimer les valeurs aberrantes et éviter le clignotement intempestif de l’écran LCD.

filter_init - Initialisation du Filtre numérique avec valeur de départ

filter_update - Filtre numérique à moyenne glissante

8.2.1.6 lcd.c
C’est le cœur de l’affichage LCD, il fourni plusieurs services qui permettent l’initialisation de l’écran, l’affichage de donnée, le rafraîchissement.

lcd_init - Initialise l'écran LCD (Mode 4 bits, curseur off, auto-incrément).

lcd_send_commande - Envoi les commandes propres à l'écran LCD

lcd_show_carac - Affiche un caractère ASCII sur le LCD.

lcd_show_txt - Affiche une chaîne de caractères à la position actuelle.

CD_PrintFloat - Affiche un flottant en utilisant un sprintf

lcd_position_cursor - Positionne le curseur à une coordonnée précise. COL (0-15) et row (0-1)

lcd_clear - Efface l'écran complet et repositionne le curseur en (0,0).

lcd_print - Affiche ligne et colonne

lcd_print_int - Affiche un entier sur le LCD.

lcd_print_float_1 - Affiche un flottant sur le LCD sans sprintf

8.2.1.7 lcd_page_manager.c
Permet de faire l’interface entre le cœur LCD et la logique du main.

19 janvier 2026 | Page 24 sur 41

lcd_page_1 – Logique du menu 1 de l’écran LCD

lcd_page_2 - Logique du menu 2 de l’écran LCD

lcd_page_3 - Logique du menu 3 de l’écran LCD

lcd_page_4 - Logique du menu 4 de l’écran LCD

lcd_page_5 - Logique du menu 5 de l’écran LCD

8.2.1.8 error_handler.c
Assure la surveillance du système, Il détecte les pannes matérielles (capteurs débranchés) ou les pannes d'actionneurs (ventilateur bloqué, réservoir vide) par une analyse temporelle.

error_handler_init - Initialisation de l'error handler

error_handler_update - Analyse les mesures et déclenche les alertes si nécessaire.

error_handler_has_error - Génération des codes erreur

### 8.2.2 Optimisation des ressources

Une contrainte majeure de notre microcontrôleur STM32G0 est la gestion de la mémoire Flash et RAM.

Affichage optimisé : Pour éviter d'inclure la bibliothèque standard stdio.h (très gourmande avec sprintf), nous avons implémenté notre propre fonction lcd_print_int.
Cette fonction décompose les entiers en caractères ASCII par des opérations de division et modulo, réduisant drastiquement l'empreinte mémoire du projet.

Attentes non-bloquantes : Au lieu d'utiliser HAL_Delay(), nous avons privilégié une fonction lcd_wait_ms basée sur HAL_GetTick().
Cela permet à la CPU de ne pas être totalement figée durant les temps de réponse du LCD, laissant la priorité aux interruptions critiques.

### 8.2.3 Logique de contrôle-commande

L'implémentation des lois de régulation a été réalisée au sein de la boucle principale (main.c) :

- Traitement ADC : Les données brutes des capteurs sont lissées par un algorithme de moyenne glissante. Cela élimine les pics de bruit électronique lors du démarrage de la pompe.
- Génération PWM : Le pilotage de la pompe utilise le Timer 16 en mode PWM. Le rapport cyclique (Duty Cycle) est calculé dynamiquement :
Duty_Cyle = (Seuil − Mesure) / K Cette approche permet un arrosage progressif, contrairement à un simple pilotage binaire.

19 janvier 2026 | Page 25 sur 41

### 8.2.4 Gestion des erreurs

Le module error_handler surveille en permanence la cohérence entre la commande et la mesure.

Si une dérive anormale est détectée (ex: humidité stagnante alors que la pompe est à 100% de puissance), le logiciel lève un FLAG d'erreur, bascule la LED de statut en mode "Défaut" et affiche le diagnostic sur la page 5 du LCD.

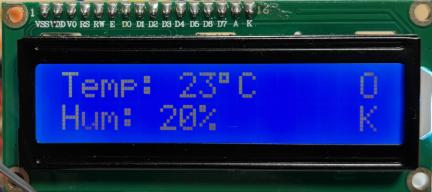
[picture p32: figure]

19 janvier 2026 | Page 26 sur 41

### 8.3.Tests et validation

Pour valider la conformité du système Greenhouse, nous avons mis en place une procédure de test rigoureuse.
Chaque test vise à vérifier un ou plusieurs System Requirements (SR) définis lors de la phase de conception.

Les tests sont présentés dans les sections 9.3.x.
Synthèse des résultats :
Exigence | ibellé | Résultat | Observations
SR-GH-001/002 | Acquisition T° / Hum | OK | Précision conforme après filtrage
SR-GH-004/005/006/007 | Régulations | OK | Hystérésis et PWM opérationnels
SR-GH-003/008/009 | Interactivité | OK | Changement de seuil fluide
SR-GH-010 | Mode manuel | OK | Mode manuel validé
SR-GH-011 | Diagnostic | OK | Détection de panne validée

### 8.3.1 Validation de la chaîne d'acquisition (SR-GH-001, 002)

L'objectif est de vérifier la précision des capteurs et le bon fonctionnement du filtrage numérique.

Protocole : Comparaison des valeurs affichées sur le LCD avec les valeurs lues en interne STM32.

Grâce à la fonction UART, la console interne à STM X_IDE permet d’afficher les valeurs brutes, traitées puis filtrées des différents capteurs. Elles sont comparées aux valeurs lues sur l’écran LCD.

Elles sont également comparées à une seconde source matérielle (thermomètre et hygromètre).

Résultat : Grâce au filtre à moyenne glissante, les valeurs sont stables. L'acquisition est validée.

Preuve :

Température et humidité, mesurées, filtrées et moyennées (moyenne glissante).

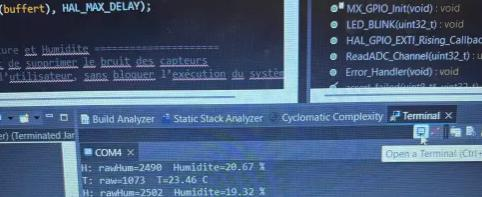
[picture p33: figure]
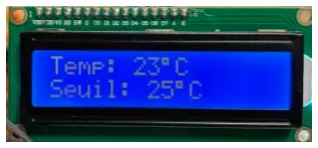
[picture p34: figure]

19 janvier 2026 | Page 27 sur 41

Température et humidité en sortie du DAC .

### 8.3.2 Validation des boucles de régulation (SR-GH-004, 005, 006, 007)

Nous avons testé la réactivité des actionneurs face à des variations de l'environnement.

Test Température : En approchant une source de chaleur du TMP235, le ventilateur s'active dès le franchissement du seuil. L'arrêt se fait correctement après refroidissement sous le seuil d'hystérésis.

Test Humidité : En sortant le capteur capacitif du substrat humide, nous avons observé l'accélération progressive de la pompe via le signal PWM, confirmant la loi de commande proportionnelle.

Résultat : Les boucles de régulation sont validées.

Preuve : vérifié lors de la présentation avec l’enseignant.

### 8.3.3 Validation de l'IHM et de l'interactivité (SR-GH-003, 008, 009)

Ce test vérifie que l'utilisateur peut piloter la serre sans reprogrammer le code

Protocole : Navigation à travers les 5 menus et modification des seuils via les boutons.

Résultat : Le lcd_page_manager réagit instantanément aux interruptions des boutons. Les nouvelles consignes sont immédiatement prises en compte par les boucles de régulation.

Preuve :

Menu1

Menu2

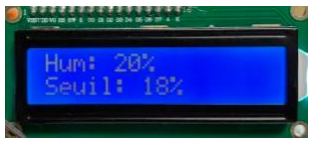
[picture p35: figure]
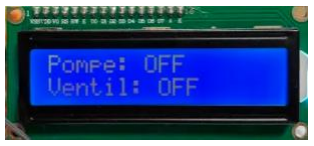
[picture p36: figure]
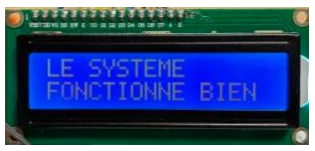
[picture p37: figure]

19 janvier 2026 | Page 28 sur 41

Menu3

Menu4

Menu5

### 8.3.4 Validation de l'IHM et de l'interactivité (SR-GH-010)

Ce test vérifie que l'utilisateur peut piloter les actionneurs en mode manuel.

Protocole : Aller sur le menu4 de l’écran LCD.

- Lire l’état des actionneurs
- Activer la pompe puis la désactiver
- Activer le ventilateur puis le désactiver
- Activer les deux
- Quitter le menu 4

Résultat : La lecture des actionneurs correspond bien à leur état. Ils s’activent/désactivent séparément mais aussi ensemble. Le système repasse en automatique lors de la transition vers un autre menu.

Preuve :

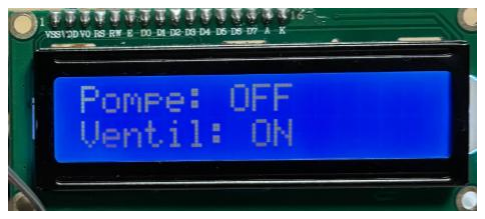
[picture p38: figure]
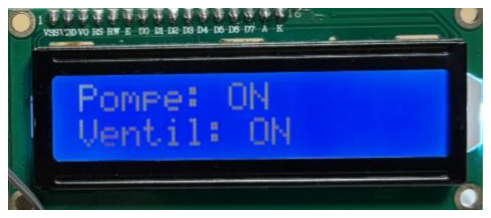
[picture p39: figure]
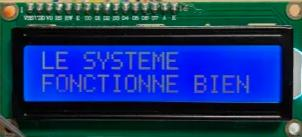
[picture p40: figure]

19 janvier 2026 | Page 29 sur 41

### 8.3.5 Test de sécurité et diagnostic (SR-GH-011)

Il s'agit de vérifier que le système "sait" quand il ne fonctionne plus.

Protocole : Simulation de défaillances (une à la fois puis tout en semble) :

- Déconnexion du capteur d'humidité
- Déconnexion du capteur de température
- Consigne de température « inatteignable » pour le système
- Consigne de d’humidité « inatteignable » pour le système

Résultat : Le système est passé par tous les états d’erreur

- "LE SYSTEME FONCTIONNE BIEN" : Aucune anomalie détectée.
- "FAN SYSTEM KO" : Détecté si problème sur le système de régulation de la température.
- "PUMP SYSTEM KO" : Détecté si problème sur le système de régulation de l’humidité

Preuve :

LE SYSTEME FONCTIONNE BIEN

FAN SYSTEM KO

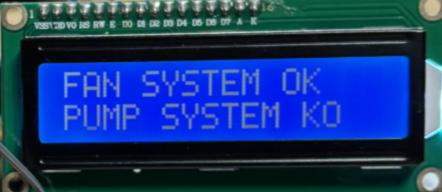
[picture p41: figure]

19 janvier 2026 | Page 30 sur 41

PUMP SYSTEM KO

19 janvier 2026 | Page 31 sur 41

### 9. Gestion de projet / management

### 9.1.Exigences demandées

La note de cadrage du projet « Conception d’une serre intelligente » impose explicitement une analyse du management de projet dans le rapport technique sur la conduite du projet

Cette exigence vise à évaluer la capacité à mener un projet technique structuré dans un temps contraint de 38 heures, en mobilisant des méthodes de gestion adaptées à un projet d’ingénierie embarquée.

### 9.1.Organisation de l’équipe

Le projet a été organisé selon une approche séquentielle structurée, adaptée à un projet de réalisation de prototype.

L’organisation repose sur les principes suivants :

Séparation claire entre phases d’étude et réalisations ;

Validation des choix techniques avant le passage à la phase suivante ;

Centralisation de la conception logicielle et matérielle à chaque fin de phases.

Cette organisation permet de limiter les retours en arrière coûteux en temps et de sécuriser les étapes critiques du projet.

### 9.2.Répartition des tâches

La répartition des tâches est représentée ici sous la forme d’un diagramme Gantt, couvrant l’intégralité des 38 heures allouées au projet.

La planification respecte une organisation en journées de travail de 8 heures (4 h matin / 4 h après-midi), avec une dernière journée partielle afin de respecter strictement le volume horaire imposé. Le travail sur le temps personnel n’est pas représenté ici.

Chaque personne a réalisé un des rôles clés lors d’un projet :

Chef de projet, Développeur logiciel, Ingénieur système.

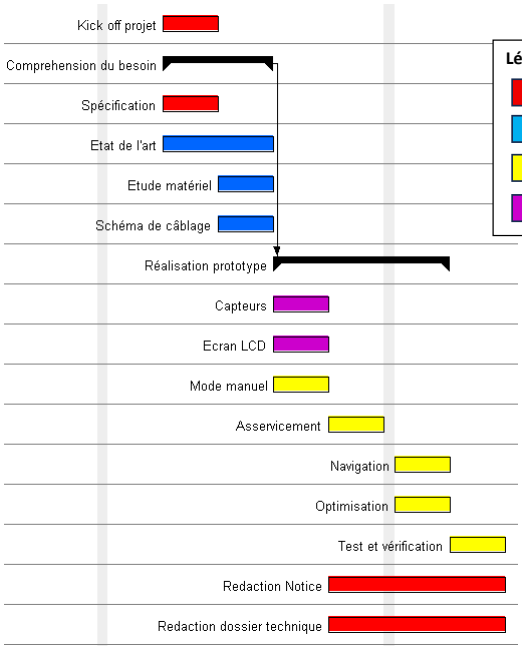
[picture p42: figure]

19 janvier 2026 | Page 32 sur 41

### 9.3.Difficultés rencontrées

Plusieurs difficultés ont été identifiées au cours du projet :

Dépendance forte entre les sous-systèmes : un retard sur les capteurs ou l’asservissement impacte directement les phases de test.

Temps de débogage sous-estimé initialement, notamment lors de l’intégration globale du système ainsi que lors de l’optimisation.

Gestion du temps pour rester dans le cadre des 38 heures. Le travail à la maison a été indispensables pour concrétiser le projet.

Rencontre de grand temps sans travailler sur le projet (période d’entreprise) qui implique un délai de remise en route non négligeable.

Figure 14 : Répartition de taches, diagramme Gantt

égende

Chef de projet

Ingénieur système

Développeur logiciel

Ingénieur développeur

19 janvier 2026 | Page 33 sur 41

### 10.Analyse critique

L’interface utilisateur du système, constituée d’un écran LCD et de boutons de commande, se montre réactive et stable : aucune valeur anormale ni incrémentation involontaire n’a été observée lors de son utilisation.

La partie actionneur, comprenant la pompe et le ventilateur, répond correctement aux commandes et ne présente pas d’activations ou de désactivations non désirées; toutefois, le ventilateur apparaît légèrement sous-dimensionné par rapport aux besoins du système.

Le module de mesure du prototype fonctionne de manière globalement satisfaisante, bien que la qualité des capteurs introduise une incertitude lors de l’étalonnage, entraînant des variations dans les valeurs mesurées.

Plusieurs améliorations techniques peuvent être envisagées, notamment l’ajout d’une sauvegarde des seuils en mémoire non volatile (Flash ou EEPROM) afin de garantir leur conservation après un redémarrage.
L’implémentation d’un mode veille pour optimiser la consommation énergétique apporterai un plus pour pérenniser l’utilisation du système.

Enfin, des extensions futures sont envisageables, telles que l’intégration de solutions IoT, le développement d’une application mobile ou d’un tableau de bord de supervision, ou encore l’adaptation du système à une serre de plus grande taille. Il convient toutefois de noter que certaines contraintes propres à une serre à échelle réelle ne sont pas pleinement prises en compte, en raison de l’échelle réduite du projet.

19 janvier 2026 | Page 34 sur 41

### 11. ilan du projet

Le projet de conception d’une serre intelligente a permis de mener à bien, dans un cadre temporel contraint, le développement d’un prototype fonctionnel, conforme au cahier des charges initial.

Sur le plan fonctionnel, l’ensemble des exigences définies lors de la phase de spécification a été respectées.

Le système est donc capable de :

- Mesurer la température ambiante et l’humidité du sol,
- Afficher les informations et les consignes via une interface LCD locale,
- Réguler automatiquement la température par ventilation avec hystérésis,
- Gérer l’irrigation par une commande proportionnelle PWM,
- Proposer un mode manuel permettant le pilotage direct des actionneurs,
- Détecter et signaler des situations de défaut grâce à un module de diagnostic.

Les phases de tests et validation ont confirmé la robustesse du prototype et la cohérence entre les lois de commande implémentées et les comportements observés. Les résultats obtenus montrent une bonne stabilité des mesures après filtrage ainsi qu’une réactivité satisfaisante des actionneurs face aux variations de l’environnement.

Sur le plan technique, le choix d’un développement bas niveau en langage C sur microcontrôleur STM32, sans recours à des frameworks de type Arduino, a permis une maîtrise fine des ressources matérielles et logicielles. L’architecture modulaire du code facilite la compréhension, la maintenance et l’évolution future du système.

Enfin, ce projet a également constitué un exercice concret de gestion de projet, mettant en évidence l’importance de la planification, de la coordination entre les différentes tâches et de l’anticipation des phases d’intégration et de débogage.

19 janvier 2026 | Page 35 sur 41

### 12. Conclusion

Le projet de serre intelligente a permis de réaliser un système embarqué pleinement fonctionnel, conforme aux exigences définies dans le cahier des charges. Le prototype développé assure la mesure continue de la température ambiante et de l’humidité du sol, ainsi que l’affichage local de ces données sur un écran LCD.

Le système intègre deux modes de fonctionnement distincts. En mode automatique, la température est régulée par une logique Tout-Ou-Rien avec hystérésis, tandis que l’irrigation est pilotée par une commande proportionnelle via un signal PWM, permettant un arrosage progressif et maîtrisé. En mode manuel, l’utilisateur dispose d’un contrôle direct des actionneurs, facilitant les phases de test et de maintenance.

L’ensemble est complété par une interface utilisateur interactive, permettant la navigation entre plusieurs menus et la modification des consignes sans reprogrammation, ainsi qu’un module de diagnostic assurant la détection et la signalisation des défauts. Les campagnes de tests ont validé le bon fonctionnement de l’ensemble des fonctionnalités et la robustesse du prototype.

Sur le plan technique, ce projet a permis de consolider des compétences essentielles en systèmes embarqués, notamment la programmation bas niveau en langage C sur microcontrôleur STM32, la gestion des périphériques (ADC, GPIO, timers PWM, interruptions), ainsi que la mise en œuvre de lois de régulation simples et efficaces.

Le développement d’une architecture logicielle modulaire a mis en évidence l’importance de la structuration du code, de la séparation des responsabilités et de l’optimisation des ressources mémoire et temporelles. L’intégration d’un filtrage numérique et d’un module de gestion des erreurs a également permis d’aborder des notions de fiabilité et de sûreté de fonctionnement, proches des contraintes industrielles.

D’un point de vue pédagogique, ce projet a favorisé une approche transversale mêlant électronique, automatique et informatique embarquée, tout en mettant en pratique des méthodes de gestion de projet. La planification, la répartition des tâches et la gestion du temps ont constitué des éléments clés pour mener à bien le projet dans le cadre strict des 38 heures allouées.

Plusieurs pistes d’évolution peuvent être envisagées pour enrichir le système développé. L’ajout d’une connectivité réseau permettrait une supervision à distance des paramètres de la serre et l’exploitation des données via une interface web ou une application mobile. L’intégration de
nouveaux capteurs, notamment pour la luminosité ou l’humidité de l’air, offrirait une régulation plus fine de l’environnement de culture.

À plus long terme, le prototype pourrait être étendu à une serre de plus grande échelle, avec une gestion multi-zones et des algorithmes de régulation plus avancés. Ces évolutions constitueraient une continuité logique vers une solution industrielle complète, tout en conservant l’architecture modulaire et évolutive mise en place dans ce projet.

19 janvier 2026 | Page 36 sur 41

### 13. Glossaire

Item | Description
ADC (Analog-to-Digital Converter) | Convertisseur Analogique-Numérique. Périphérique interne du microcontrôleur qui transforme une tension analogique (provenant des capteurs) en une valeur numérique traitée par le logiciel.
Cortex-M0+ | Cœur de processeur conçu par ARM, utilisé dans le STM32G031U6, reconnu pour sa très faible consommation d'énergie et son efficacité dans les systèmes embarqués.
Duty Cycle (Rapport Cyclique) | Ratio entre la durée de l'état haut et la période totale d'un signal PWM. Il détermine la puissance moyenne envoyée à la pompe (vitesse).
EXTI (External Interrupt) | Interruption externe. Mécanisme permettant au microcontrôleur de réagir instantanément à un événement extérieur (comme l'appui sur un bouton) sans scruter en permanence l'état de la broche.
GPIO (General Purpose Input/Output) | Broche universelle d'entrée ou de sortie du microcontrôleur, utilisée pour lire des boutons ou piloter des composants simples comme des LEDs ou des ventilateurs.
HA (Hardware Abstraction ayer) | Bibliothèque logicielle fournie par STMicroelectronics qui permet de piloter les périphériques du microcontrôleur sans avoir à manipuler directement les registres mémoires complexes.
Hystérésis | Écart de seuil entre l'activation et la désactivation d'un système (ici le ventilateur). Elle permet d'éviter les oscillations rapides et l'usure prématurée des composants.
IHM (Interface Homme-Machine) | Ensemble des dispositifs (écran LCD, boutons) permettant à l'utilisateur d'interagir avec le système de la serre.
CD ( iquid Crystal Display) | Écran à cristaux liquides utilisé pour afficher les données de température, d'humidité et les menus de configuration.
Moyenne Glissante | Filtre numérique simple implémenté en C pour lisser les données des capteurs en calculant la moyenne des n dernières mesures, éliminant ainsi le bruit électronique.
Pont en H | Structure électronique présente dans le module MotoDriver2 permettant de piloter des moteurs à courant continu en gérant la puissance et, si besoin, le sens de rotation.
PWM (Pulse Width Modulation) | Modulation de Largeur d'Impulsion. Technique permettant de simuler une tension variable en faisant varier la durée d'allumage d'un signal numérique. Utilisée ici pour varier le débit de la pompe.
STM32CubeIDE | Environnement de développement intégré (IDE) basé sur Eclipse, utilisé pour programmer, compiler et déboguer le code sur les cibles STM32.

19 janvier 2026 | Page 37 sur 41

### Annexes

### Specification système

Template

SR-GH-00x

Révision 00

Objet :

Rationale:

Specification

SR-GH-001

Révision 00

Objet : Greenhouse doit pouvoir acquérir la température ambiante.

Rationale: température en °C

SR-GH-002

Révision 00

Objet : Greenhouse doit pouvoir acquérir l’humidité au sol.

Rationale: humidité en %

SR-GH-003

Révision 00

Objet : Greenhouse doit pouvoir être interactif vis-à-vis de l’opérateur.

Rationale: Pas besoin de reconfiguration (nouveau téléchargement), l’opérateur peut saisir les consignes et allumer/éteindre le ventilateur et/ou la pompe.

19 janvier 2026 | Page 38 sur 41

SR-GH-004

Révision 00

Objet : Greenhouse doit pouvoir monitorer la température en fonction d’une consigne donnée.

Rationale: Consigne de température donnée par l’utilisateur.

SR-GH-005

Révision 00

Objet : Greenhouse doit pouvoir monitorer l’humidité en fonction d’une consigne donnée.

Rationale: Consigne d’humidité donnée par l’utilisateur.

SR-GH-006

Révision 00

Objet : Greenhouse doit pouvoir réguler la température dans la serre.

Rationale:

SR-GH-007

Révision 00

Objet : Greenhouse doit pouvoir réguler l’humidité dans la serre.

Rationale:

SR-GH-008

Révision 00

Objet : Greenhouse doit pouvoir afficher les informations de températures et d’humidité sur une page d’un écran LCD.
Rationale:

19 janvier 2026 | Page 39 sur 41

SR-GH-009

Révision 00

Objet : Greenhouse doit pouvoir afficher les consignes de température et d’humidité sur une page d’un écran LCD.
Rationale:

SR-GH-010

Révision 00

Objet : Greenhouse doit pouvoir afficher l’état courant du ventilateur et de la pompe.

Rationale: Afficher ON ou OFF

SR-GH-011

Révision 00

Objet : Greenhouse doit pouvoir afficher l’état du système

Rationale: Afficher Système OK ou défaut système de pompe ou défaut système de ventilation

19 janvier 2026 | Page 40 sur 41

### Design écran LCD

Menu1 :

Temperature | x°C
Humidite | x%

Menu2 :

Temperature | x°C
Seuil | x°C

Menu3 :

Humidite | x%
Seuil | x%

Menu4 :

Pompe | ON/OFF
Ventilateur | ON/OFF

Menu5 :

LE SYSTEME
FONCTIONNE BIEN

Ou

FAN SYSTEM | OK/KO
PUMP SYSTEM | OK/KO

19 janvier 2026 | Page 41 sur 41

### Notice d’utilisation

La notice d’utilisation du système est disponible au format pdf.

NOTICE.pdf
