Lucas-byte31/GREENHOUSE_V2/02_SW_SPEC/readme.txt

On déposera ici les documents de specification
