Lucas-byte31/GREENHOUSE_V2/02_SW_SPEC/Datasheet/ESP32_WROOM_32.jpg

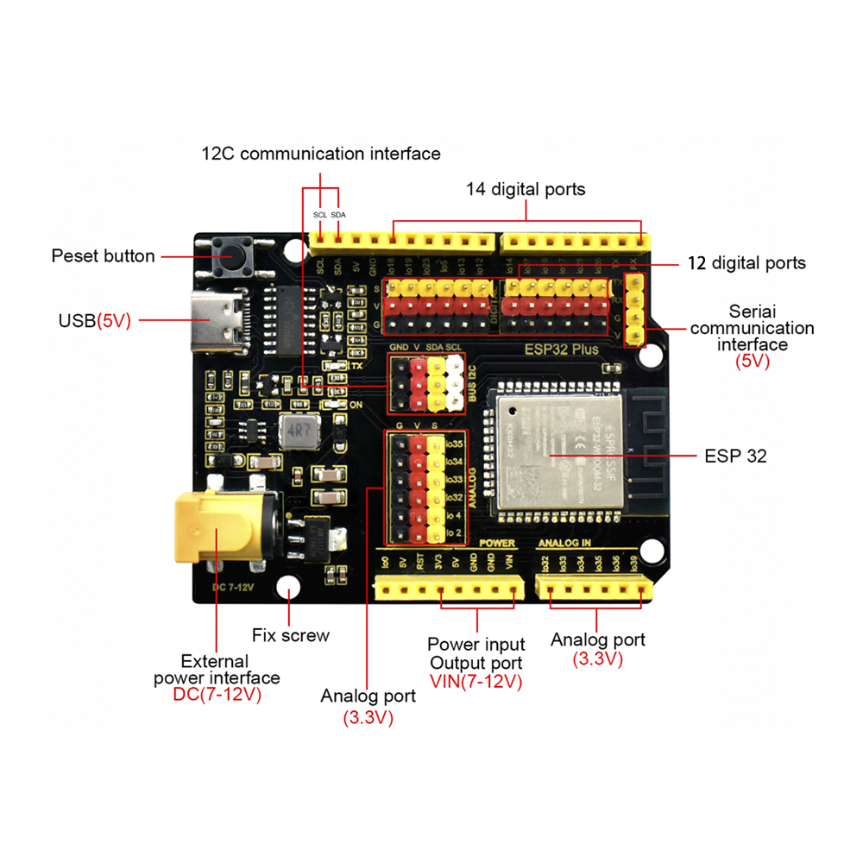
02_SW_SPEC/Datasheet/ESP32_WROOM_32.jpg
