Lucas-byte31/GREENHOUSE_V2/02_SW_SPEC/Photos/Menu1_ko.png

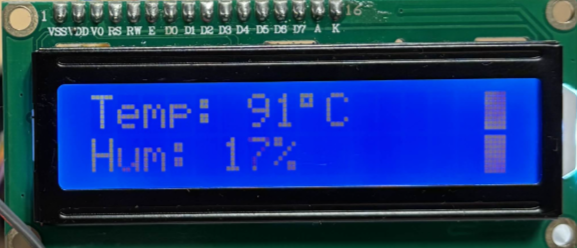
02_SW_SPEC/Photos/Menu1_ko.png
