Lucas-byte31/GREENHOUSE_V2/02_SW_SPEC/Photos/Menu2_ok.png

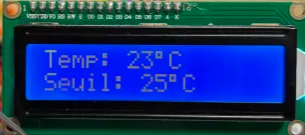
02_SW_SPEC/Photos/Menu2_ok.png
