Lucas-byte31/GREENHOUSE_V2/02_SW_SPEC/Photos/Menu4_ONOFF.png

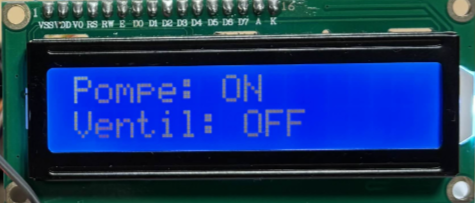
02_SW_SPEC/Photos/Menu4_ONOFF.png
