Lucas-byte31/GREENHOUSE_V2/(commit log)

2026-10-22 update schema de cablage
2026-11-04 Migration STM2 vers ESP32 ARDUINO env
2026-11-10 Add traces results
